konstantinbsv/scp-controller/Board Renders/SCP Green PCB.jpg

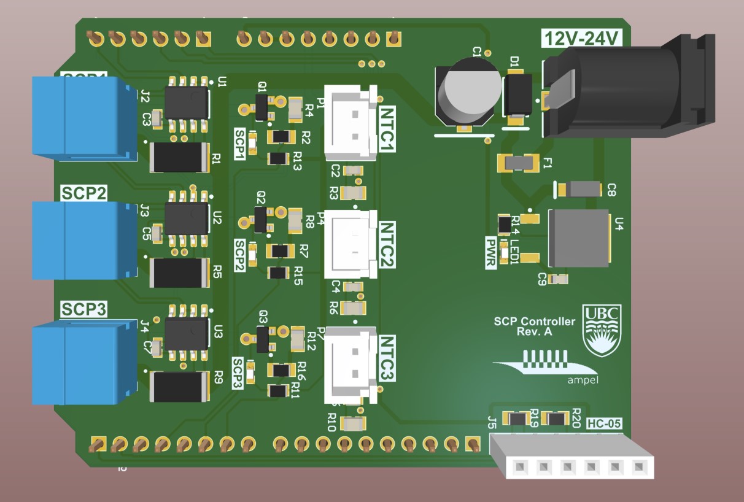
Board Renders/SCP Green PCB.jpg
