konstantinbsv/scp-controller/Board Renders/SCP Blue PCB.jpg

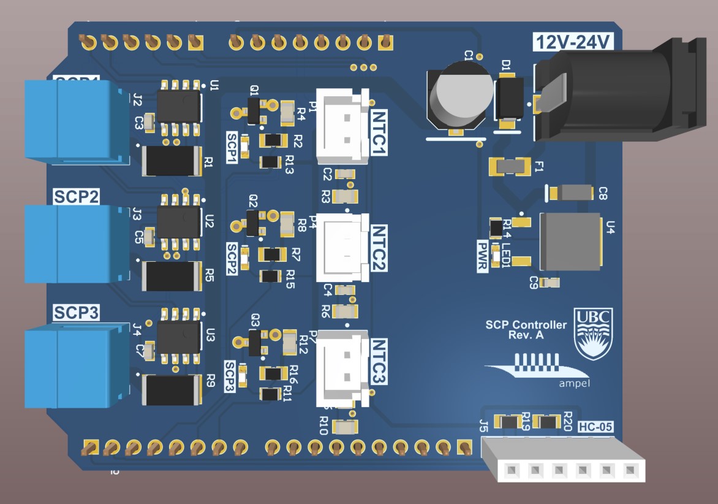
Board Renders/SCP Blue PCB.jpg
