konstantinbsv/scp-controller/SCP Controller Design Document.docx

IRLML6244TRPbF was chosen as the driving MOSFT as it has a drain current of 5.1A, more than enough to drive the SCPs. It is logic level, V_(GS(th)) =1.1V and R_(DS(on)) =21 mΩ @ V_(GS) =4.5V , which will allow it to be driven effectively by 5V logic.

Adding a gate resistor will reduce the gate charging current, which will reduce the possibility of damage to the MCU and help to dampen ringing with the trace parasitic capacitance. A high value pull-down resistor is added to reduce capacitive coupling and inadvertent charging of the gate.

A 100k NTC with a B-value of 3950K was chosen as these are widely used on 3D printers (e.g. RepRap), and so are inexpensive and easily sourced. The 100k NTC will also exhibit lower self-heating than a 10k NTC. The average operation temperature of the SCPs is 70oC.

The corresponding JST XH-series connector was used for the NTC.

At this temperature the NTC’s resistance is ≈18kΩ , so a resistor of 18k was chosen to put the average temperature in the center of the voltage divider’s range.

A 0.1uF capacitor was added across the 18k resistor to help filter out high frequency noise from the NTC signal.

For quick connect/disconnect of the SCP fibers a pluggable, screw terminal block was chosen:

a) Male (board-side) CUI Devices TBP02R1-381-02BE (https://www.digikey.com/product-detail/en/cui-devices/TBP02R1-381-02BE/102-6480-ND/10238457), Female (SCP-side) CUI Devices TBP02P1-381-02BE (https://www.digikey.com/product-detail/en/cui-devices/TBP02P1-381-02BE/102-6468-ND/10238445).
b) Amphenol Anytek 381-series - Male (board-side) OQ0232510000G (https://www.digikey.com/product-detail/en/amphenol-anytek/OQ0232510000G/609-3819-ND/2261255), Female (SCP-side) TJ0231530000G (https://www.digikey.com/product-detail/en/amphenol-anytek/TJ0231530000G/609-3797-ND/2261289).

From option a) was chosen as the Anytek 381-series is older and appears as discontinued by some suppliers.

Red LED current-limiting resistor calculation. V_F = 1.9V, and I_F = 10mA for 130mcd. R_(RLED) =(5V-1.9V)/(10mA)=310Ω→300Ω

Red LED current-limiting resistor calculation. V_F = 2.0V, and I_F = 11mA for 20mcd. R_(RGREEN) =(5V-2.0V)/(11mA)=273Ω→270Ω
