konstantinbsv/scp-controller/Board Renders/SCP Black PCB.jpg

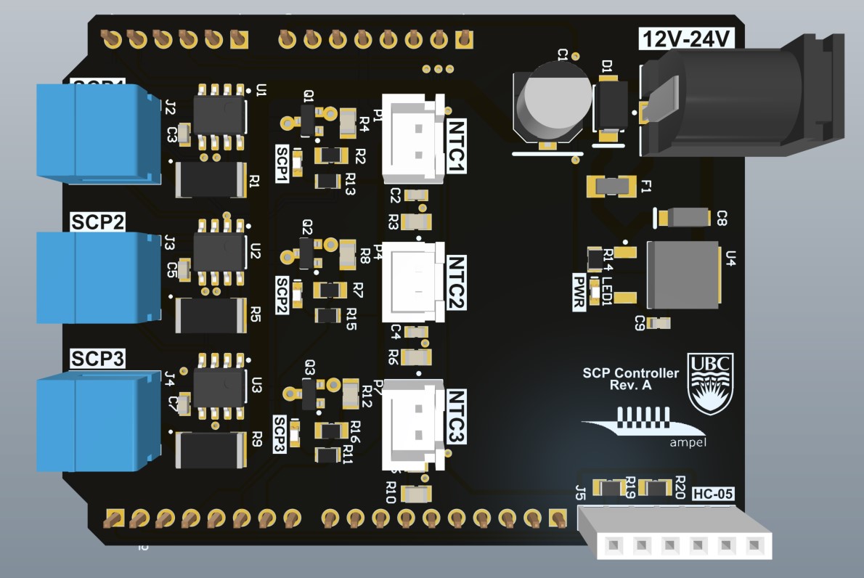
Board Renders/SCP Black PCB.jpg
