konstantinbsv/scp-controller/Board Renders/SCP White PCB.jpg

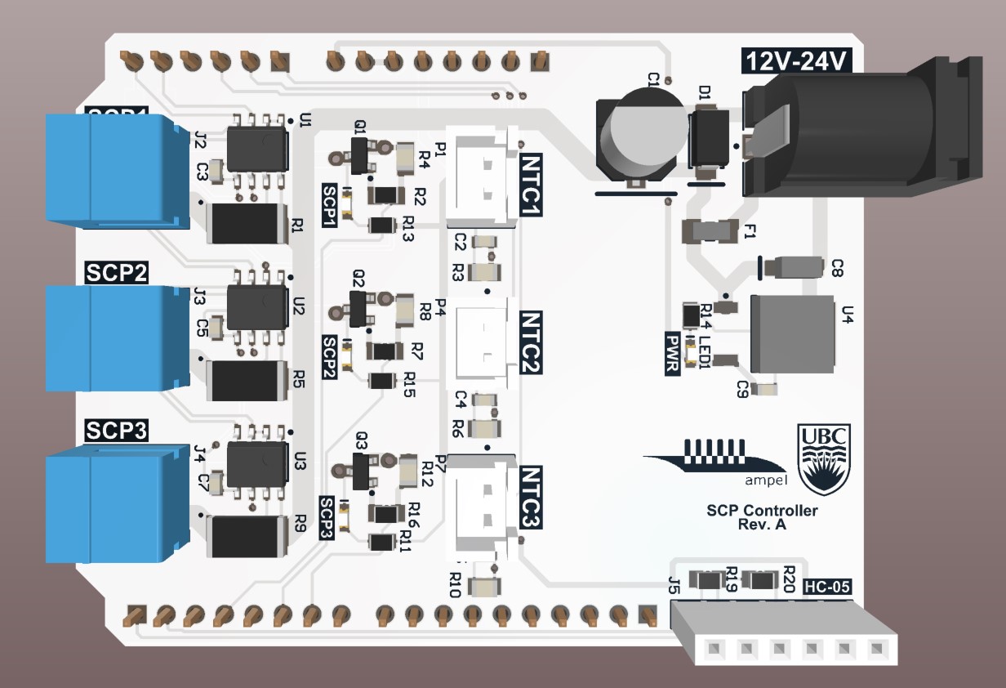
Board Renders/SCP White PCB.jpg
