konstantinbsv/scp-controller/SCP_Altium/Project Outputs for SCP_Controller/BOM/SCP_Controller-BOM.xlsx

Designator | Comment | Description | Manufacturer | Manufacturer Part Number | Supplier 1 | Quantity | Supplier Part Number 1 | Pricing 1 | Supplier Currency 1
C1 | 47uF 35V | Aluminum Electrolytic Capacitor, 47 uF, +/- 20%, 35 V, 2-Pin SMD (Size Code D), -55 to 105 degC, RoHS, Tape and Reel | Panasonic | EEE-1VA470WP | Digi-Key | 1 | PCE3961CT-ND | 1=0.41000, 10=0.28400, 100=0.17040, 500=0.12782 (USD)
C2, C3, C4, C5, C6, C7, C9 | 0.1uF |  | Murata | GCJ188R71E104KA12D | Digi-Key | 7 | 490-16477-1-ND | 1=0.20000, 10=0.13300, 100=0.06740, 500=0.04610, 1000=0.04079 (USD)
C8 | 0.33uF 35V |  | KEMET | T491A334K035AT | Digi-Key | 1 | 399-3693-1-ND | 1=0.45000, 10=0.31300, 100=0.18770, 500=0.14076, 1000=0.11886 (USD)
D1 | B360A | Schottky Barrier Rectifier, 3 A, -55 to 150 degC, 2-Pin Molded, RoHS, Tape and Reel | DiodesIncorporated | B360A-13-F | Digi-Key | 1 | B360A-FDIDKR-ND | 1=0.38000, 10=0.30800, 100=0.17690, 500=0.16380, 1000=0.11138 (USD)
F1 | 6A |  | Bel TRP | C1F6 | Digi-Key | 1 | 507-1887-1-ND | 1=0.29000, 5=0.27800, 10=0.26500, 50=0.23660, 100=0.22030, 250=0.19584, 500=0.16320, 1000=0.15504 (USD)
J1 | 24V 5A Max | DC Power Jack, 5 A, -25 to 85 degC, 3-Pin THD, RoHS | CUI | PJ-102AH | Digi-Key | 1 | CP-102AH-ND | 1=0.76000, 10=0.70800, 25=0.63720, 50=0.56640, 100=0.54280, 250=0.49560, 500=0.47200, 1000=0.38940, 2500=0.35400 (USD)
J2, J3, J4 | SCP_1 |  | CUI | TBP02R1-381-02BE | Digi-Key | 3 | 102-6480-ND | 1=0.47000, 10=0.24600, 25=0.17440, 50=0.14820, 100=0.14300, 250=0.12092, 500=0.11180, 1000=0.09880, 5000=0.07540 (USD)
J5 | HC-05 | SQ Post Socket, Through-hole, Vertical, -55 to 105 degC, 2.54mm Pitch, 6-Pin, Female, RoHS | Samtec | PPPC061LFBN-RC | Digi-Key | 1 | S7039-ND | 1=0.53000, 10=0.50000, 100=0.38300, 500=0.33300, 1000=0.27473, 5000=0.24143, 10000=0.24050 (USD)
LED1 | GREEN | SMD mono-color Chip LED, WL-SMCW, Bright Green | Wuerth Elektronik | 150060VS75000 | Digi-Key | 1 | 732-4980-1-ND | 1=0.14000, 50=0.13300, 100=0.11400, 500=0.09900 (USD)
LED2, LED3, LED4 | RED | SMD mono-color Chip LED, WL-SMCW, Red | Wuerth Elektronik | 150060RS75000 | Digi-Key | 3 | 732-4978-1-ND | 1=0.14000, 50=0.13300, 100=0.11400, 500=0.09900 (USD)
P1, P4, P7 | NTC_1 | Male Header, Pitch 2.5 mm, 1 x 2 Position, Height 7 mm, Tail Length 3.4 mm, -25 to 85 degC, RoHS, Bulk | JST |  | Digi-Key | 3 | 455-2247-ND
P2 | POWER | THT Vertical Pin Header WR-PHD, Pitch 2.54 mm, Single Row, 8 pins | Wurth Elektronik |  | Digi-Key | 1 | 732-5321-ND
P3 | ANALOG | THT Vertical Pin Header WR-PHD, Pitch 2.54 mm, Single Row, 6 pins | Wurth Elektronik |  | Digi-Key | 1 | 732-5319-ND
P5 | DIGITAL_1 | THT Vertical Pin Header WR-PHD, Pitch 2.54 mm, Single Row, 8 pins | Wurth Elektronik |  | Digi-Key | 1 | 732-5321-ND
P6 | DIGITAL_2 | THT Vertical Pin Header WR-PHD, Pitch 2.54 mm, Single Row, 10 pins | Wurth Elektronik |  | Digi-Key | 1 | 732-2670-ND
Q1, Q2, Q3 | IRLML6244TRPBF | HEXFET(R) Power MOSFET , 20 V, -55 to 150 degC, 3-Pin SOT-23, RoHS, Tape and Reel | International Rectifier |  | Digi-Key | 3 | IRLML6244TRPBFCT-ND
R1, R5, R9 | 0.1R | RES 0.1 OHM 1% 1W 2512 | Yageo | RL2512FK-070R1L | Digi-Key | 3 | 311-0.1TCT-ND | 1=0.54000, 10=0.38200, 100=0.19890, 1000=0.10709 (USD)
R2, R7, R11 | 100R | Chip Resistor, 100 Ohm, +/-1%, 0.125 W, -55 to 155 degC, 0805 (2012 Metric), RoHS, Tape and Reel | Yageo | RC0805FR-07100RL | Digi-Key | 3 | 311-100CRCT-ND | 1=0.10000, 10=0.04000, 100=0.01630, 1000=0.00731, 2500=0.00635 (USD)
R3, R6, R10 | 18k 0.5% |  | Panasonic | ERA-6AED183V | Digi-Key | 3 | P123817CT-ND | 1=0.11000, 10=0.10300, 25=0.07120, 50=0.05540, 100=0.03960, 250=0.03088, 500=0.02456, 1000=0.01742 (USD)
R4, R8, R12 | 1M |  | Yageo | RC0805FR-071ML | Digi-Key | 3 | 311-1.00MCRCT-ND | 1=0.100000, 10=0.040000, 100=0.016300, 1000=0.007310, 2500=0.006350 (USD)
R13, R15, R16 | 300R | Chip Resistor, 300 Ohm, +/- 1%, 125 mW, -55 to 155 degC, 0805 (2012 Metric), RoHS, Tape and Reel | Yageo | RC0805FR-07300RL | Digi-Key | 3 | 311-300CRCT-ND | 1=0.10000, 10=0.04000, 100=0.01630, 1000=0.00731, 2500=0.00635 (USD)
R14 | 270R | Chip Resistor, 270 Ohm, +/- 1%, 125 mW, -55 to 155 degC, 0805 (2012 Metric), RoHS, Tape and Reel | Yageo | RC0805FR-07270RL | Digi-Key | 1 | 311-270CRCT-ND | 1=0.10000, 10=0.04000, 100=0.01630, 1000=0.00731, 2500=0.00635 (USD)
R17, R18 | 3.3k | Chip Resistor, 3.3 KOhm, +/- 1%, 0.125 W, -55 to 155 degC, 0805 (2012 Metric), RoHS, Tape and Reel | Yageo | RC0805FR-073K3L | Digi-Key | 2 | 311-3.30KCRCT-ND | 1=0.10000, 10=0.04000, 100=0.01630, 1000=0.00731, 2500=0.00635 (USD)
R19 | 1k | Chip Resistor, 1 KOhm, +/- 1%, 125 mW, -55 to 155 degC, 0805 (2012 Metric), RoHS, Tape and Reel | Yageo | RC0805FR-071KL | Digi-Key | 1 | 311-1.00KCRCT-ND | 1=0.10000, 10=0.04000, 100=0.01630, 1000=0.00731, 2500=0.00635 (USD)
R20 | 2k | Chip Resistor, 2 KOhm, +/- 1%, 125 mW, -55 to 155 degC, 0805 (2012 Metric), RoHS, Tape and Reel | Yageo | RC0805FR-072KL | Digi-Key | 1 | 311-2.00KCRCT-ND | 1=0.10000, 10=0.04000, 100=0.01630, 1000=0.00731, 2500=0.00635 (USD)
U1, U2, U3 | INA219AIDR | Zero-Drift, Bi-Directional Current / Power Monitor, 3 to 5.5 V, -40 to 125 degC, 8-pin SOIC (D8), Green (RoHS & no Sb/Br) | Texas Instruments | INA219AIDR | Digi-Key | 3 | 296-23978-1-ND | 1=2.14000, 10=1.92200, 25=1.81280, 100=1.45020, 250=1.26896, 500=1.23270, 1000=0.97891 (USD)
U4 | 9V 0.5A |  | ON Semiconductor | MC78M09CDTRKG | Digi-Key | 1 | MC78M09CDTRKGOSCT-ND | 1=0.43000, 10=0.37000, 25=0.34520, 100=0.25650, 250=0.21708, 500=0.20720, 1000=0.15294 (USD)
