konstantinbsv/scp-controller/SCP_Altium/STEP Files/CUI_DEVICES_TBP02R1-381-02BE.step

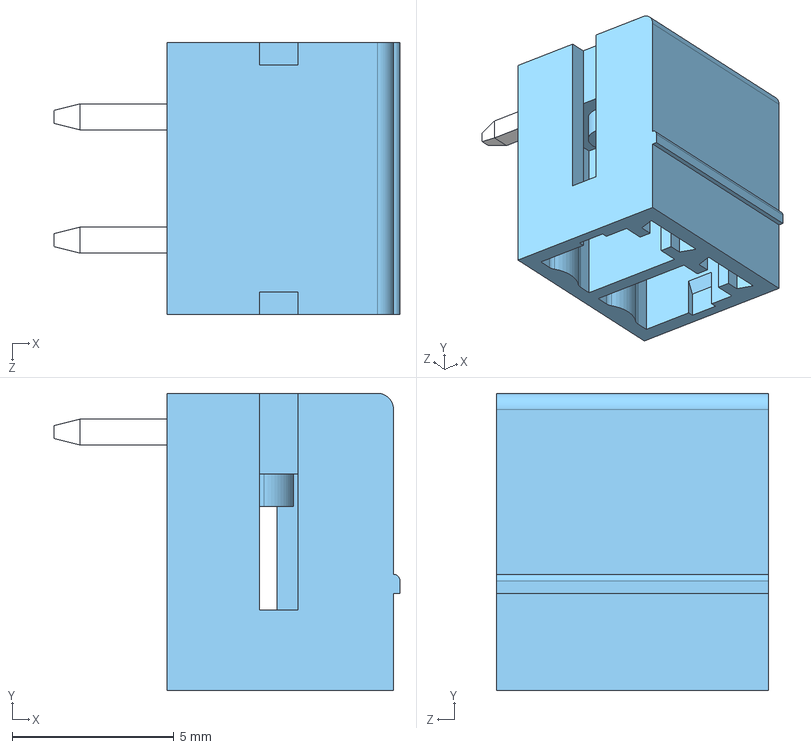
[picture p5: CAD file, 2020-01-14]
SCP_Altium/STEP Files/CUI_DEVICES_TBP02R1-381-02BE.step
10.7 x 9.20 x 8.41 mm
