konstantinbsv/scp-controller/(list of files, drawings)

Other design files:
SCP_Altium/Footprints and Symbols/Imported TBP02R1-381-02BE.lia/TBP02R1-381-02BE.PcbLib
SCP_Altium/Footprints and Symbols/Imported TBP02R1-381-02BE.lia/TBP02R1-381-02BE.SchLib
SCP_Altium/SCP_Controller.PcbDoc
SCP_Altium/SCP_Controller.PrjPcb
SCP_Altium/SCP_Controller.SchDoc
