konstantinbsv/scp-controller/(commit log)

2020-01-14 Add JST XH-Series connectors
    [SCP_Controller.SchDoc]
2020-01-14 Add thermistor resistors
    [SCP_Controller.PcbDoc, SCP_Controller.SchDoc]
2020-01-14 Add INA219
    [SCP_Controller.SchDoc]
2020-01-14 Add 2.54mm male headers
    [SCP_Controller.SchDoc]
2020-01-14 Add suplier links to headers
    [SCP_Controller.SchDoc]
2020-01-14 Add CUI terminal STEP, symbol, and footprint
    [CUI_DEVICES_TBP02R1-381-02BE.step, SCP_Controller.SchDoc]
2020-01-15 Add filtering capacitors to INA219 and low-pass to NTC
    [SCP_Controller.SchDoc, TBP02R1-381-02BE.PcbLib, TBP02R1-381-02BE.SchLib]
2020-01-17 Add STEP file to CUI connector
    [SCP_Controller.SchDoc, TBP02R1-381-02BE.PcbLib, TBP02R1-381-02BE.SchLib]
2020-01-17 Annotate schematic
    [SCP_Controller.SchDoc]
2020-01-17 Initial PCB update from schematic
    [SCP_Controller.PcbDoc]
2020-01-17 Compile CUI connector intergrated library
    [SCP_Controller.PcbDoc, SCP_Controller.SchDoc]
2020-01-17 Update PCB with new CUI footprints and 3D models
    [SCP_Controller.PcbDoc]
2020-01-17 Set board outline and size
    [SCP_Controller.PcbDoc, SCP_Controller.SchDoc]
2020-01-17 Create initial layout
    [SCP_Controller.PcbDoc]
2020-01-17 Add 9V voltage regulator to power Arduino
    [SCP_Controller.PcbDoc, SCP_Controller.SchDoc]
2020-01-18 Update document parameters
    [SCP_Controller.PcbDoc, SCP_Controller.PrjPcb, SCP_Controller.SchDoc]
2020-01-20 Add status LEDs
    [SCP_Controller.PcbDoc, SCP_Controller.SchDoc]
2020-01-20 Add fuse and reverse polarity protection
    [SCP_Controller.SchDoc]
2020-01-21 Fix LED current limiting resistors
    [SCP_Controller.PcbDoc, SCP_Controller.SchDoc]
2020-01-21 Change INA219 package to 8-SOIC
    [SCP_Controller.PcbDoc, SCP_Controller.SchDoc]
2020-01-21 Redefine board shape to make more room for SCP connectors
    [SCP_Controller.PcbDoc]
2020-01-21 Add I2C pull-up resistors
    [SCP_Controller.PcbDoc, SCP_Controller.SchDoc]
2020-01-21 Route INA219s
    [SCP_Controller.PcbDoc, SCP_Controller.SchDoc]
2020-01-21 Swap SCP LEDs and resistors for neater layout
    [SCP_Controller.PcbDoc, SCP_Controller.SchDoc]
2020-01-21 Reverse NTC analog connections for neater layout
    [SCP_Controller.PcbDoc, SCP_Controller.SchDoc]
2020-01-21 Finish routing NTCs
    [SCP_Controller.PcbDoc]
2020-01-21 Increase via sizes for SCP driving circuit
    [SCP_Controller.PcbDoc]
2020-01-21 Finish routing 5V rail
    [SCP_Controller.PcbDoc, SCP_Controller.SchDoc]
2020-01-21 Pour GND plane polygon
    [SCP_Controller.PcbDoc]
2020-01-21 Add connector and LED labels
    [SCP_Controller.PcbDoc, SCP_Controller.SchDoc]
2020-01-21 Resize and move designators
    [SCP_Controller.PcbDoc, SCP_Controller.SchDoc]
2020-01-22 Set board origin
    [SCP_Controller.PcbDoc, SCP_Controller.PrjPcb]
2020-01-22 Add connector for HC-05 Bluetooth module
    [SCP_Controller.PcbDoc, SCP_Controller.SchDoc]
2020-01-22 Route HC-05 connector
    [SCP_Controller.PcbDoc, SCP_Controller.SchDoc]
2020-01-22 Reroute and shorten V_SCP track
    [SCP_Controller.PcbDoc]
2020-01-22 Place logos on silkscreen
    [SCP_Controller.PcbDoc]
2020-01-22 Increase board size by 10mil on right edge
    [SCP_Controller.PcbDoc]
2020-01-22 Run DRC check and fix via clearances
    [SCP_Controller.PcbDoc]
2020-01-22 Generate Gerbers and NC drill files
    [SCP_Controller.GBL, SCP_Controller.GBO, SCP_Controller.GBP, SCP_Controller.GBS, SCP_Controller.GM1, SCP_Controller.GTL, SCP_Controller.GTO, SCP_Controller.GTP]
2020-01-22 Add board dimensions
    [SCP_Controller.PcbDoc]
2020-01-22 Add board renders
2020-01-22 Save CAM files
    [SCP_Controller.PrjPcb]
2020-01-22 Update Gerbers and drill files
    [SCP_Controller.PcbDoc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]
2020-01-22 Generate primitives from board shape
    [SCP_Controller.PcbDoc]
2020-01-22 Regenerate Gerbers and drill files
    [SCP_Controller.PcbDoc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]
2020-01-22 Generate BOM
    [SCP_Controller-BOM.xlsx, SCP_Controller.PcbDoc]
2020-01-22 Update PCB color
    [SCP_Controller.PcbDoc, SCP_Controller.PrjPcb]
2020-01-22 Update white PCB render
2020-01-22 Update MOSFET calculations
2020-01-23 Fix alignment of right-side Arduino connectors
    [SCP_Controller.PcbDoc, SCP_Controller.PrjPcb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]
